tahnok/teensy2nicenano/README.md

# Teensy2nicenano

Goal: make my original ergodox bluetooth capable by replacing the teensy 2.0 with a nice!nano v2

## Revision

### R1 

Errata:

 - The i2c pins (SDA and SCL) are swapped
 - The battery switch needs a solder jumper between pins 2 and 3
