tahnok/teensy2nicenano/schematic.pdf

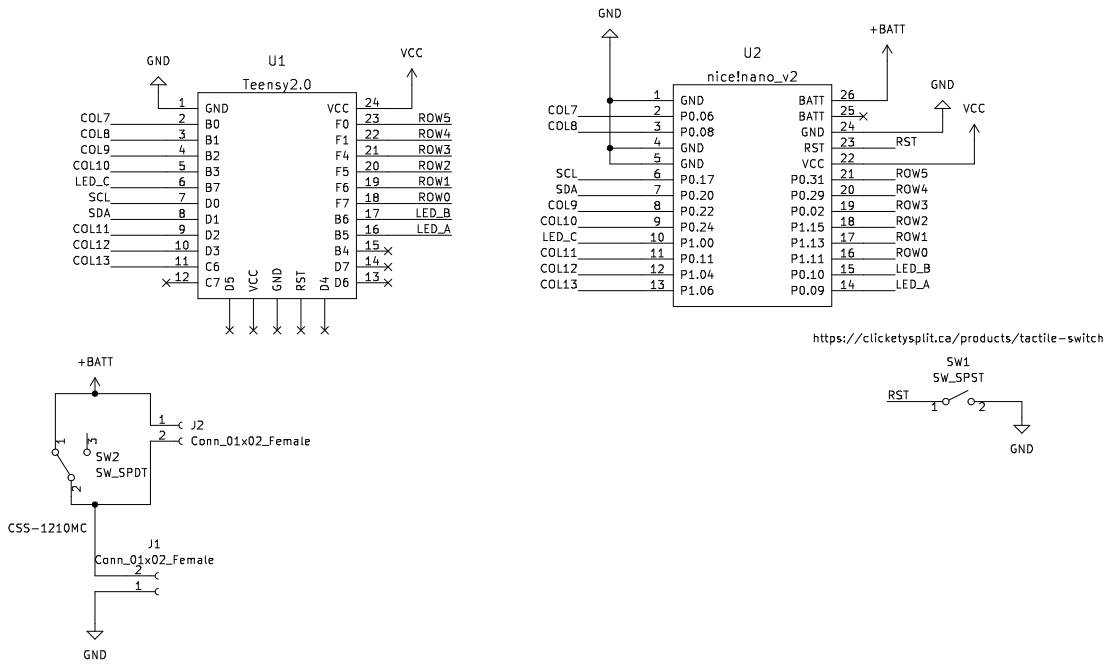
[picture p1: page 1]
