tahnok/teensy2nicenano/teensy2nicenano.kicad_pcb

## KiCad design teensy2nicenano.kicad_pcb (2023-01-26)

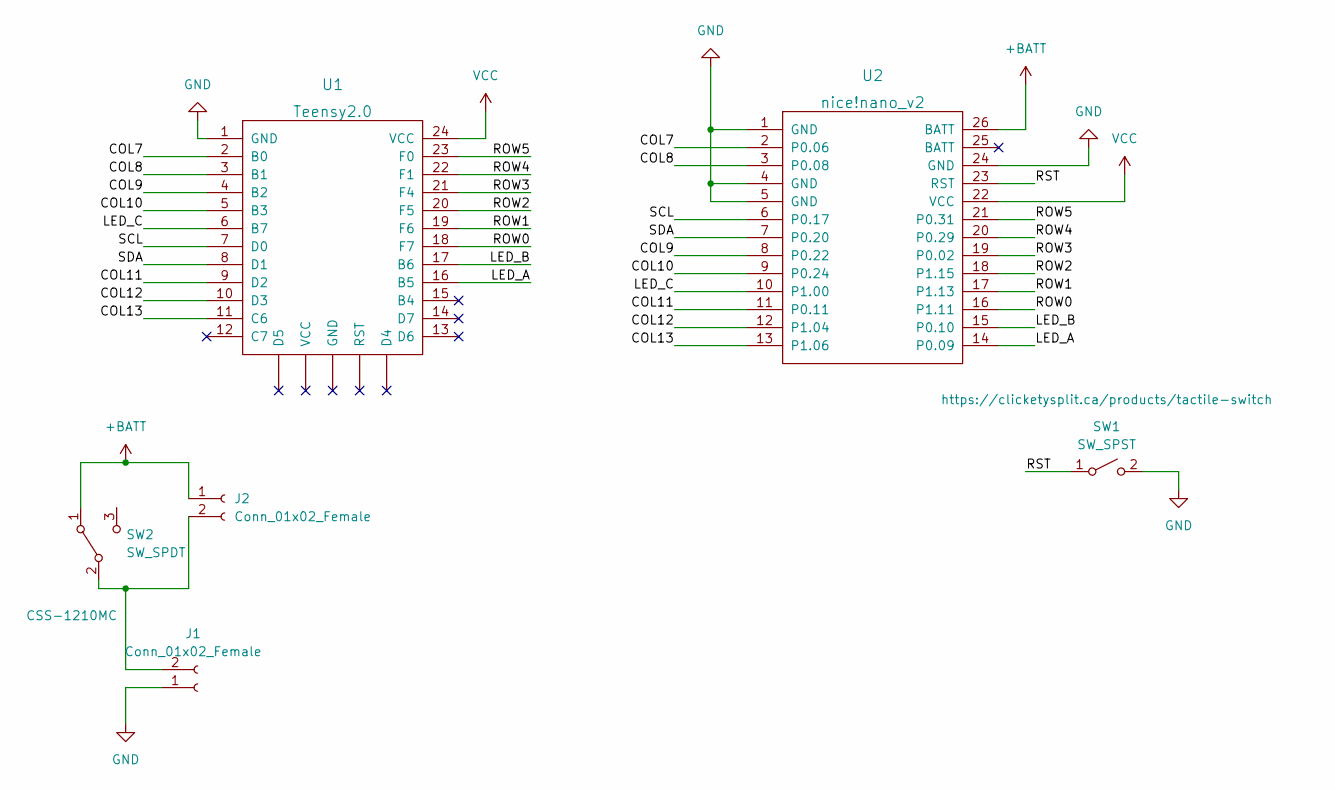
[picture p2: schematic teensy2nicenano.kicad_sch, teensy to nice!nano]

Parts:
J1: Conn_01x02_Female; PinHeader_2x1mm_P2mm_SMD_RA
J2: Conn_01x02_Female; PinHeader_1x02_P2.54mm_Vertical
SW1: SW_SPST; ResetSW
SW2: SW_SPDT; SPDT_right_angle; Digikey part CSS-1210MC
U1: Teensy2.0; Teensy2.0_trim
U2: nice!nano_v2; nice!nano v2

Connections:
+BATT: J2.1, SW2.1 (A), U2.26 (BATT)
/COL7: U1.2 (B0), U2.2 (P0.06)
/COL8: U1.3 (B1), U2.3 (P0.08)
/COL9: U1.4 (B2), U2.8 (P0.22)
/COL10: U1.5 (B3), U2.9 (P0.24)
/COL11: U1.9 (D2), U2.11 (P0.11)
/COL12: U1.10 (D3), U2.12 (P1.04)
/COL13: U1.11 (C6), U2.13 (P1.06)
/LED_A: U1.16 (B5), U2.14 (P0.09)
/LED_B: U1.17 (B6), U2.15 (P0.10)
/LED_C: U1.6 (B7), U2.10 (P1.00)
/ROW0: U1.18 (F7), U2.16 (P1.11)
/ROW1: U1.19 (F6), U2.17 (P1.13)
/ROW2: U1.20 (F5), U2.18 (P1.15)
/ROW3: U1.21 (F4), U2.19 (P0.02)
/ROW4: U1.22 (F1), U2.20 (P0.29)
/ROW5: U1.23 (F0), U2.21 (P0.31)
/RST: SW1.1 (A), U2.23 (RST)
/SCL: U1.7 (D0), U2.6 (P0.17)
/SDA: U1.8 (D1), U2.7 (P0.20)
GND: J1.1, SW1.2 (B), U1.1 (GND), U2.1 (GND), U2.4 (GND), U2.5 (GND), U2.24 (GND)
unnamed: J1.2, J2.2, SW2.2 (B)
VCC: U1.24 (VCC), U2.22 (VCC)

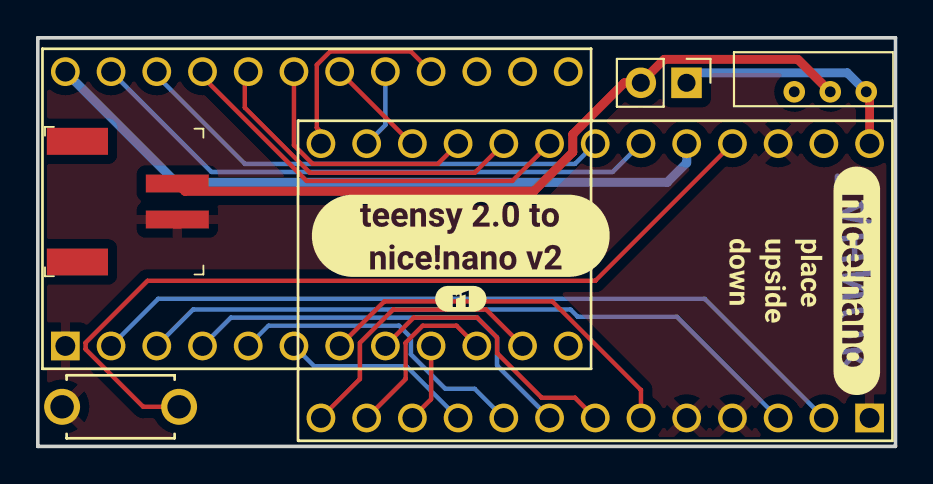
[picture p3: board teensy2nicenano.kicad_pcb from above]

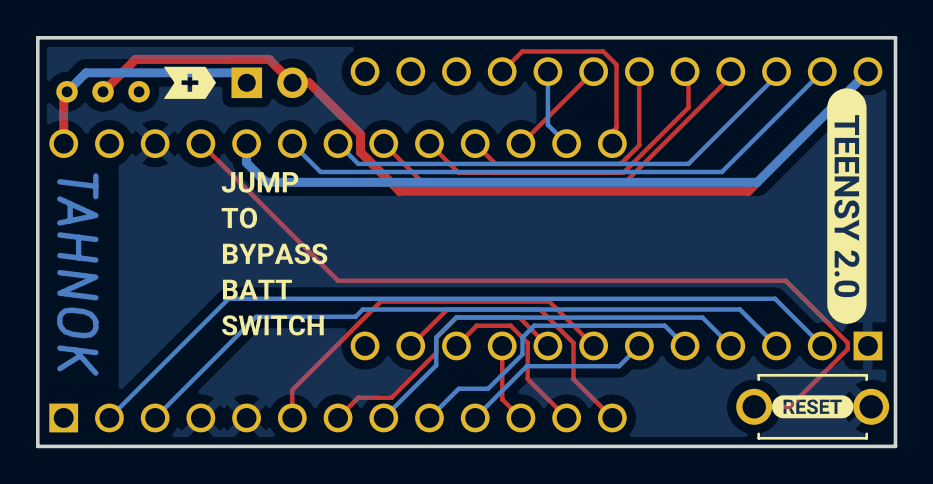
[picture p4: board teensy2nicenano.kicad_pcb from below]

Board: 2 copper layers, 47.7 x 22.7 mm, 14 parts (5 on the bottom side), 23 nets.

Other parts of the board:
kibuzzard-63CD6A48: G***; kibuzzard-63CD6A48
kibuzzard-63CD6B63: G***; kibuzzard-63CD6B63
kibuzzard-63CD8B85: G***; kibuzzard-63CD8B85
kibuzzard-63CD8F8E: G***; kibuzzard-63CD8F8E
kibuzzard-63CD60DD: G***; kibuzzard-63CD60DD
kibuzzard-63CD68E3: G***; kibuzzard-63CD68E3
kibuzzard-63CD68FE: G***; kibuzzard-63CD68FE
kibuzzard-63CD693F: G***; kibuzzard-63CD693F
