tahnok/teensy2nicenano/(threads)

Thread 1 (2024-01-14):

Status

cpebble, 2024-01-14:
Hey Tahnok
Starting the same project. Just wanted to know, did you get this working? What pitfalls should one know before attempting similar

tahnok, 2024-01-16:
It works great, except I had swapped the i2c pins on the PCB and had to fix that in software.

If you're interested I can mail you an extra PCB

cpebble, 2024-01-17:
Actually that would be cool!
I'm in Europe so I don't know about shipping, however you can reach out to me on Matrix @christian:cpj.nu

tahnok, 2024-01-19:
I sent you a message on matrix
